LemonRhyme/xmicro-memory/README.md

# XMICRO-MEMORY

[XMICRO](https://github.com/x-microsystems/xmicro-bus) card providing 1MB of RAM and an optional relocatable 8KB EEPROM.

[Datasheet](Documentation/XMICRO-MEMORY.pdf)
