LemonRhyme/xmicro-memory/Documentation/Schematics/XMICRO-MEMORY V1.0 Black Large.pdf

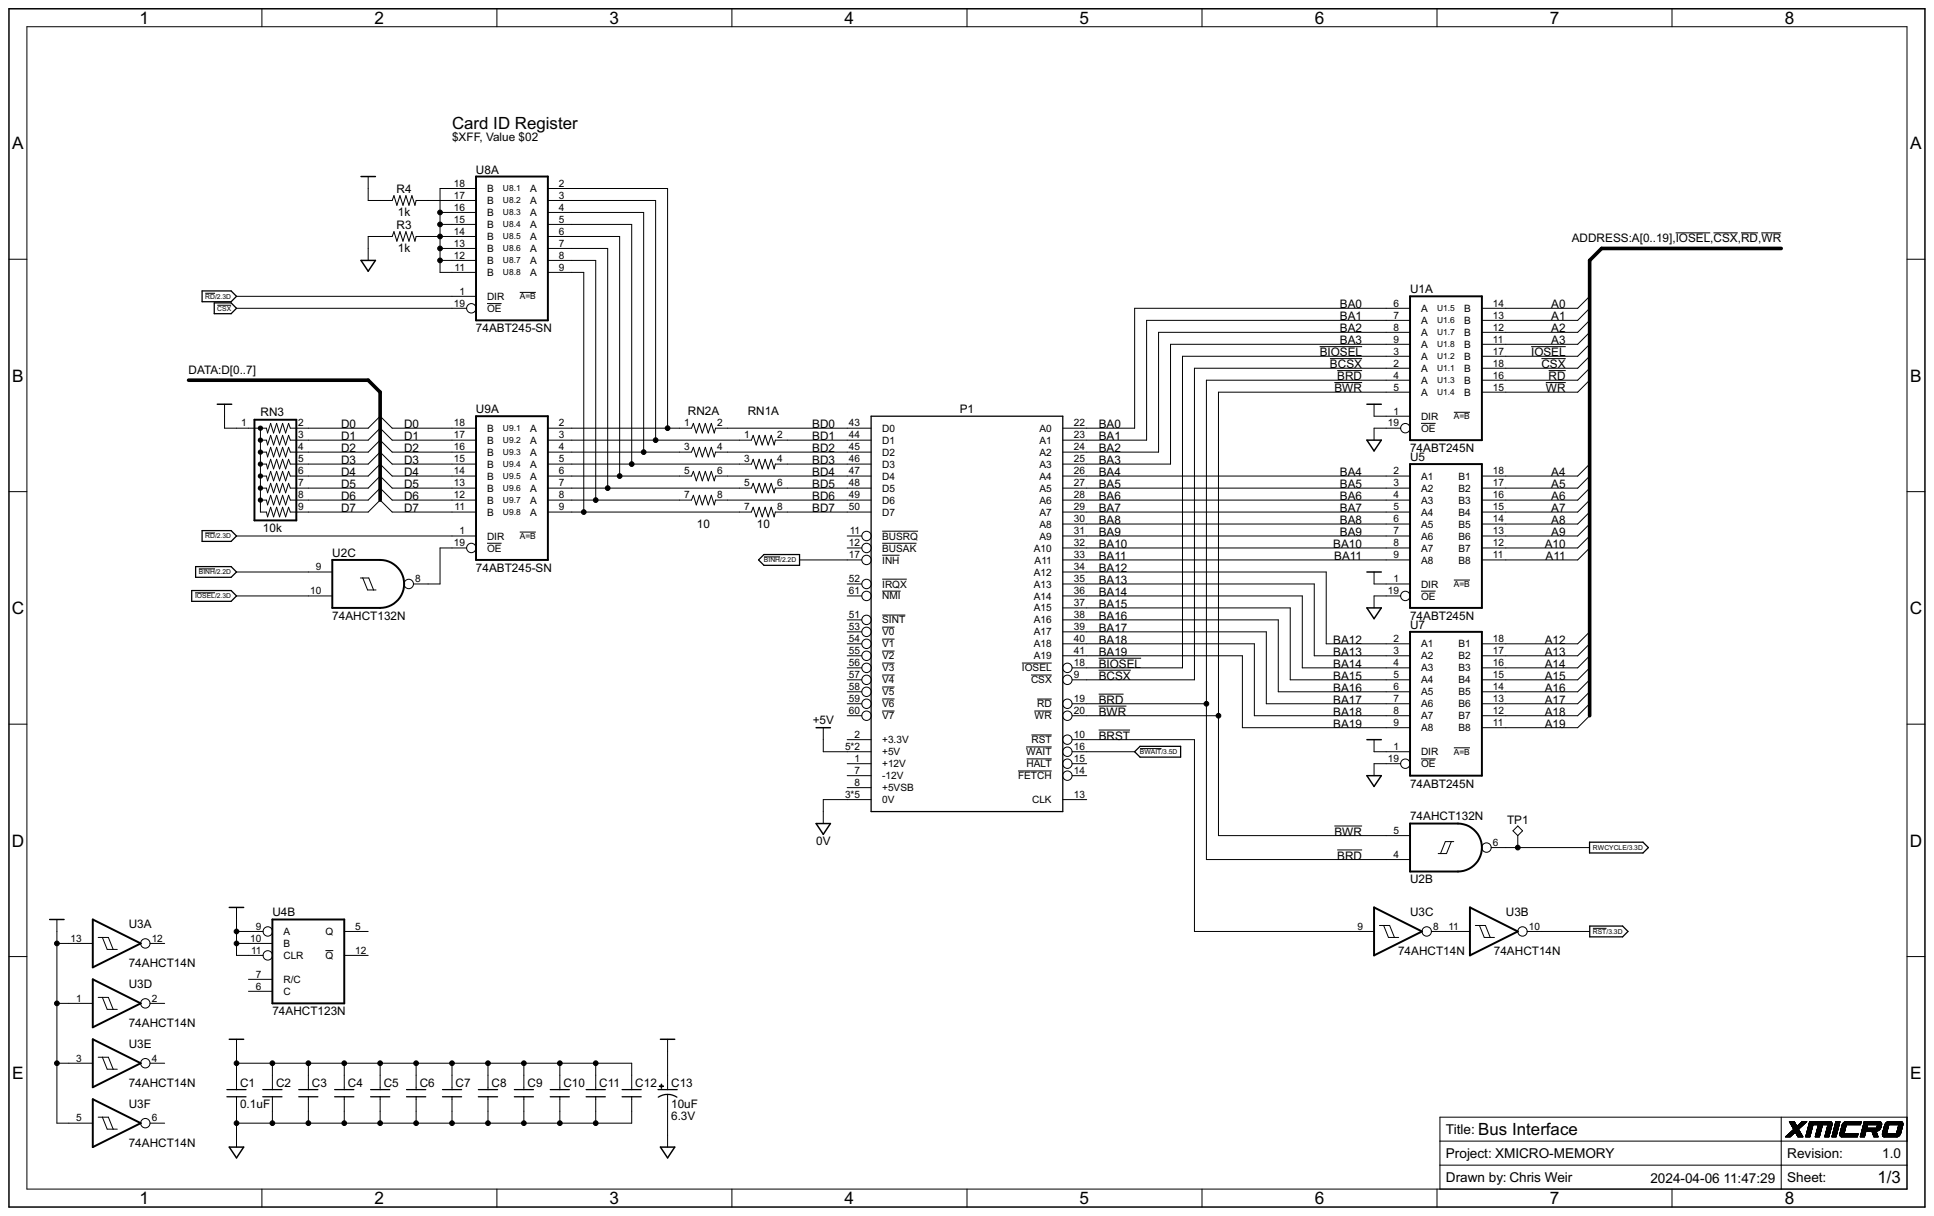
[picture p4: page 1]
