LemonRhyme/xmicro-memory/Documentation/Schematics/XMICRO-MEMORY V1.0 Color Large.pdf

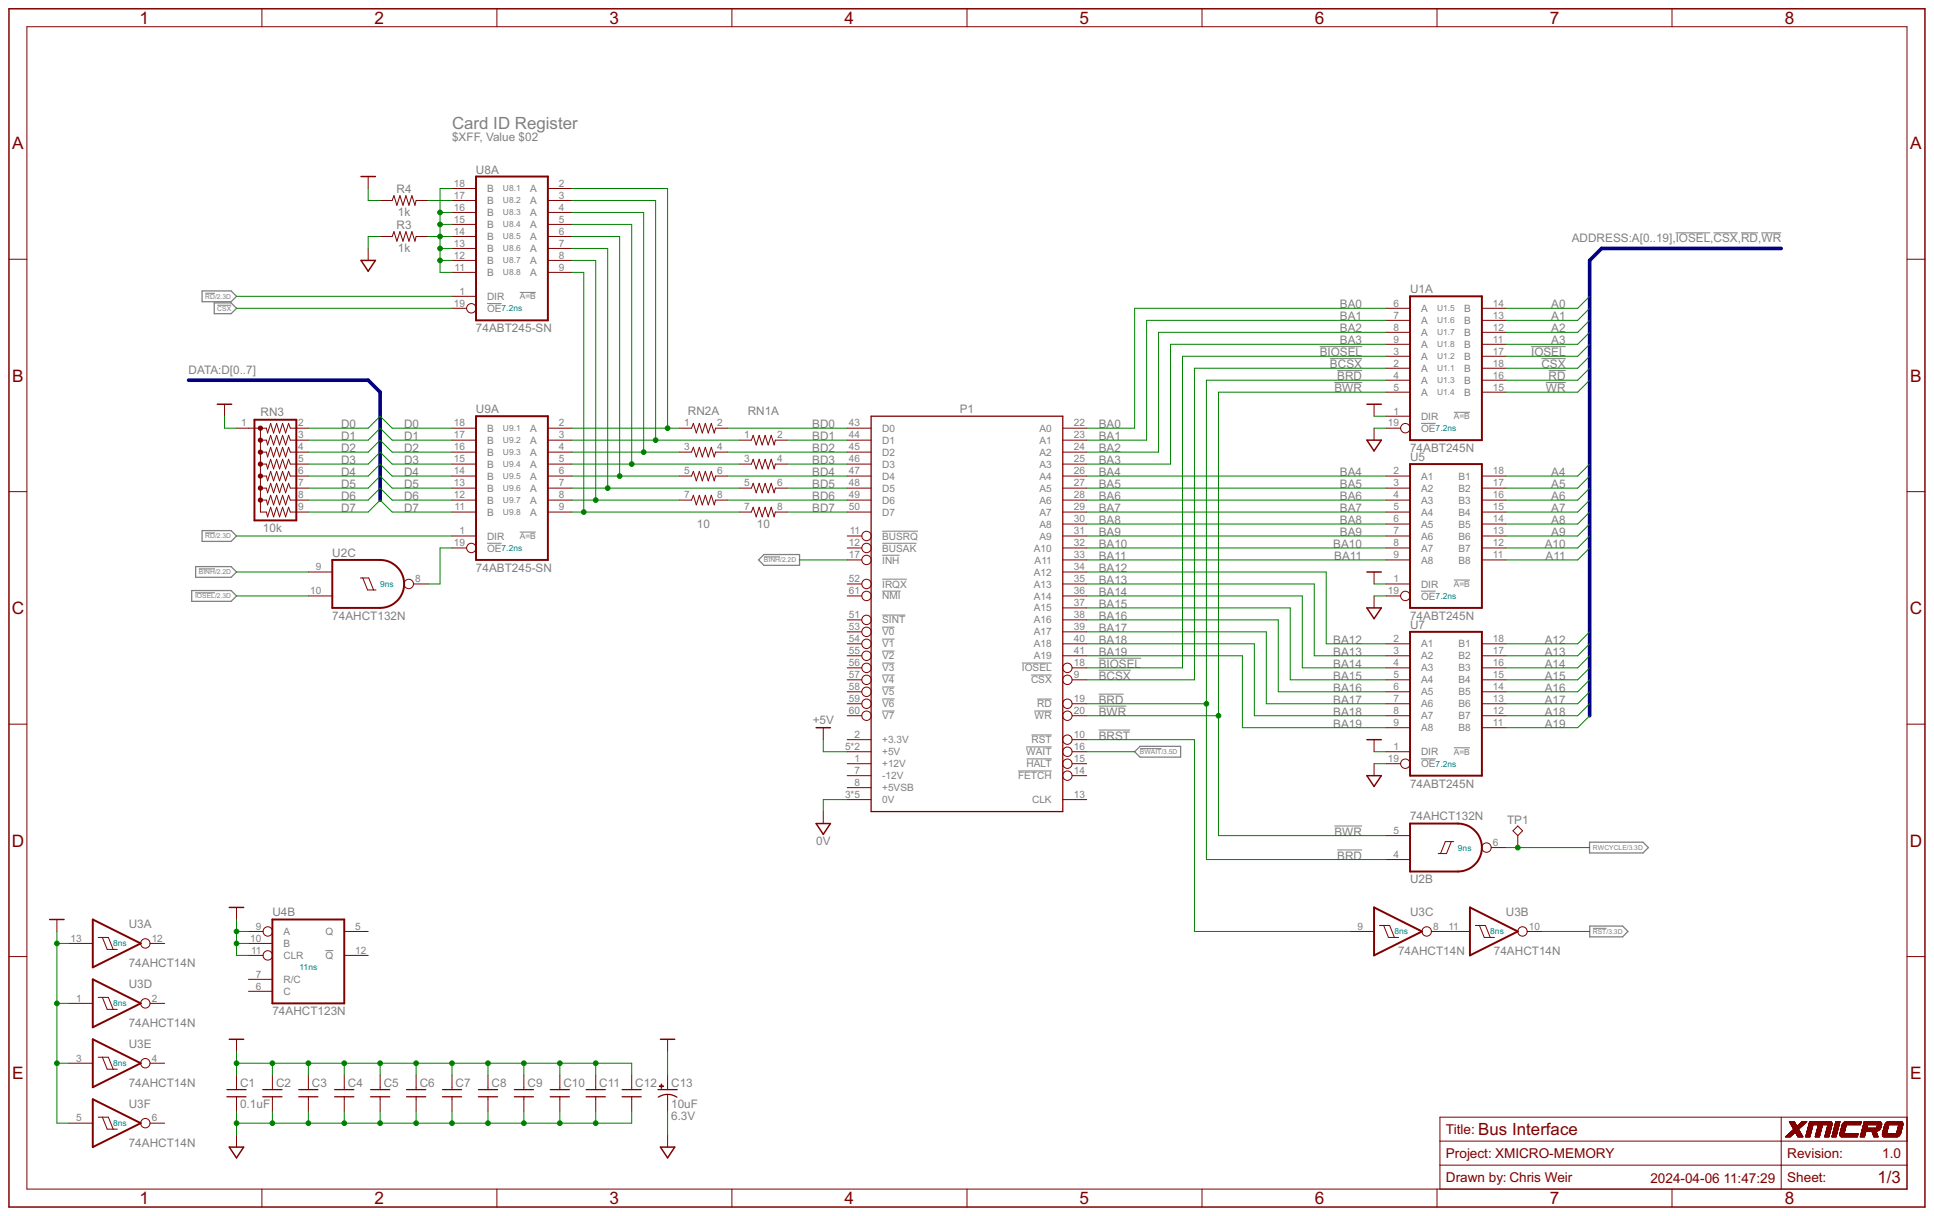
[picture p8: page 1]
