LemonRhyme/xmicro-memory/Documentation/Schematics/XMICRO-MEMORY V1.0 Color.pdf

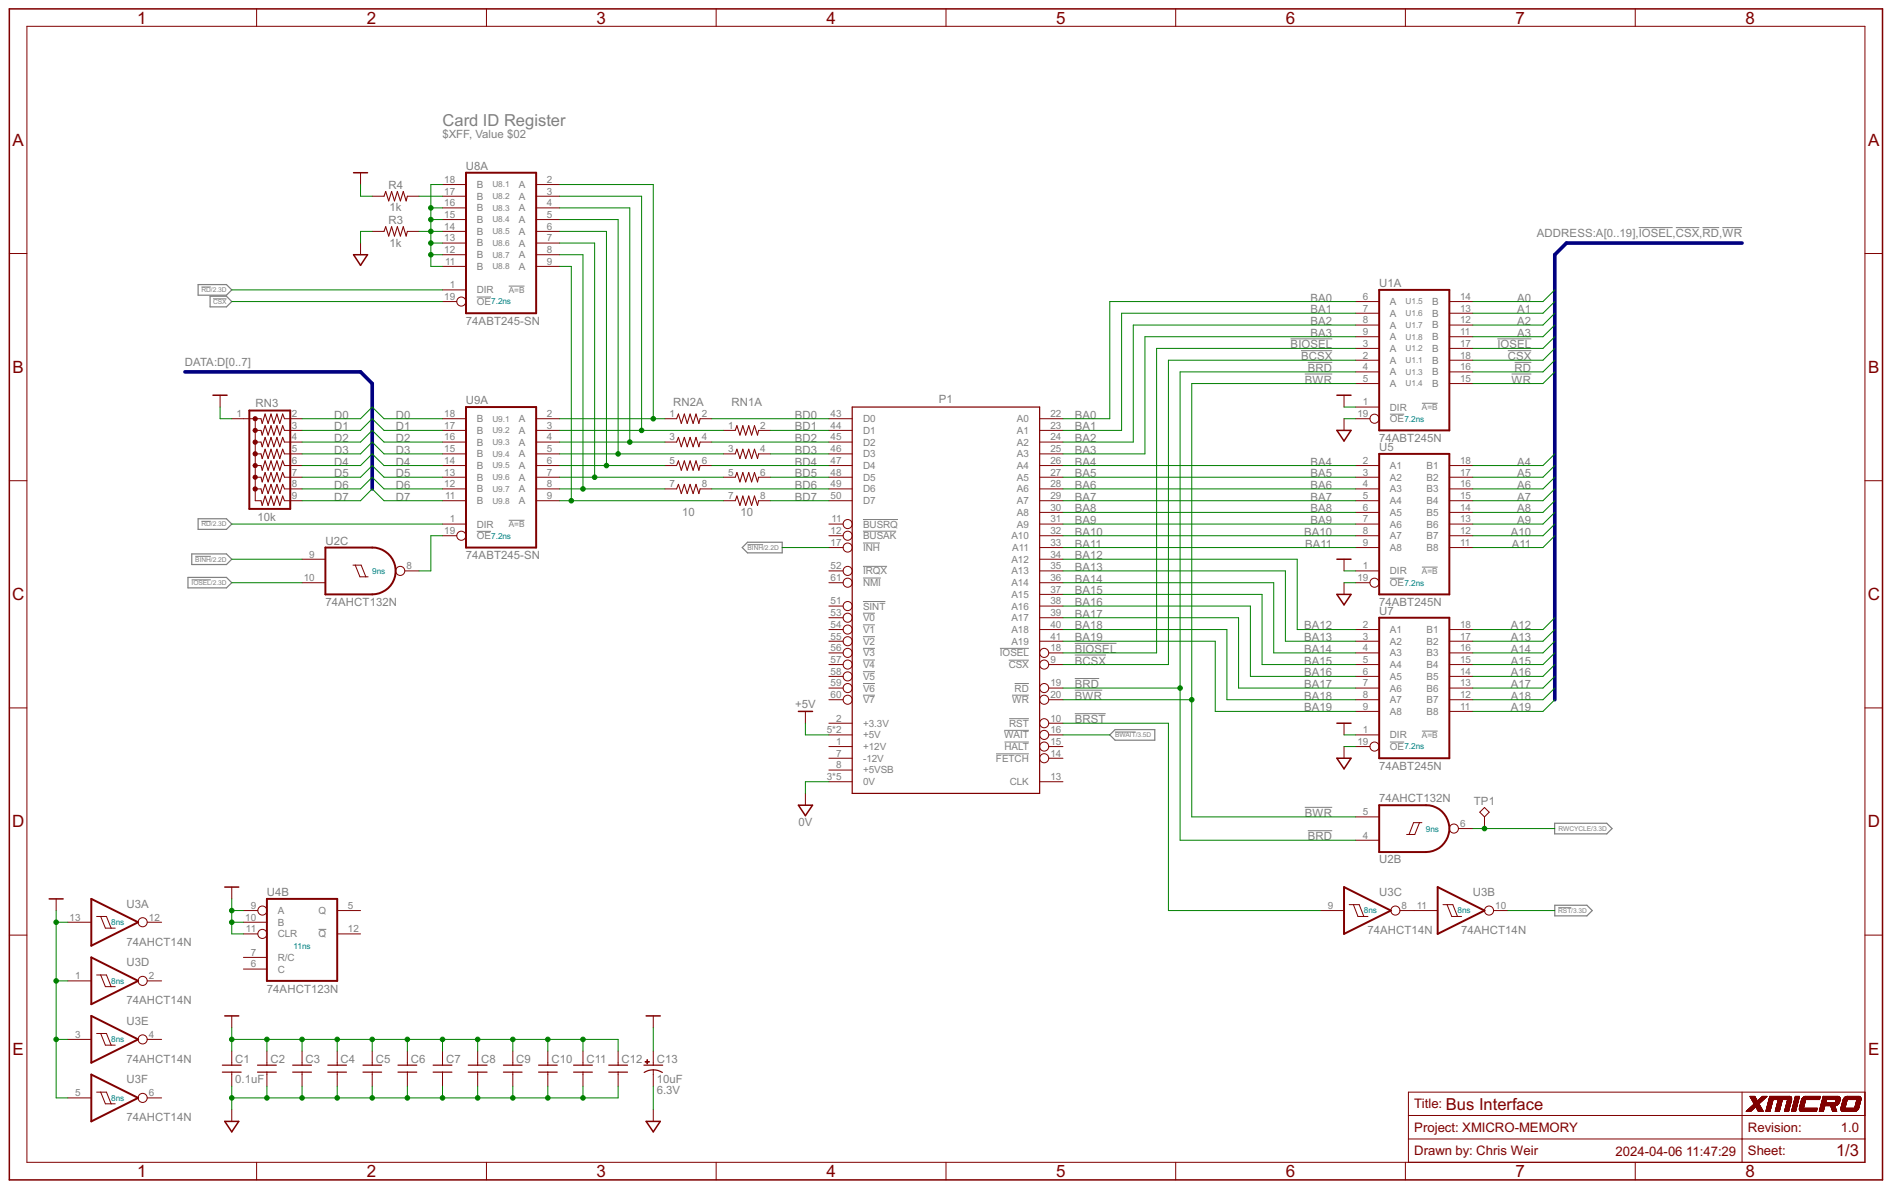
[picture p9: page 1]

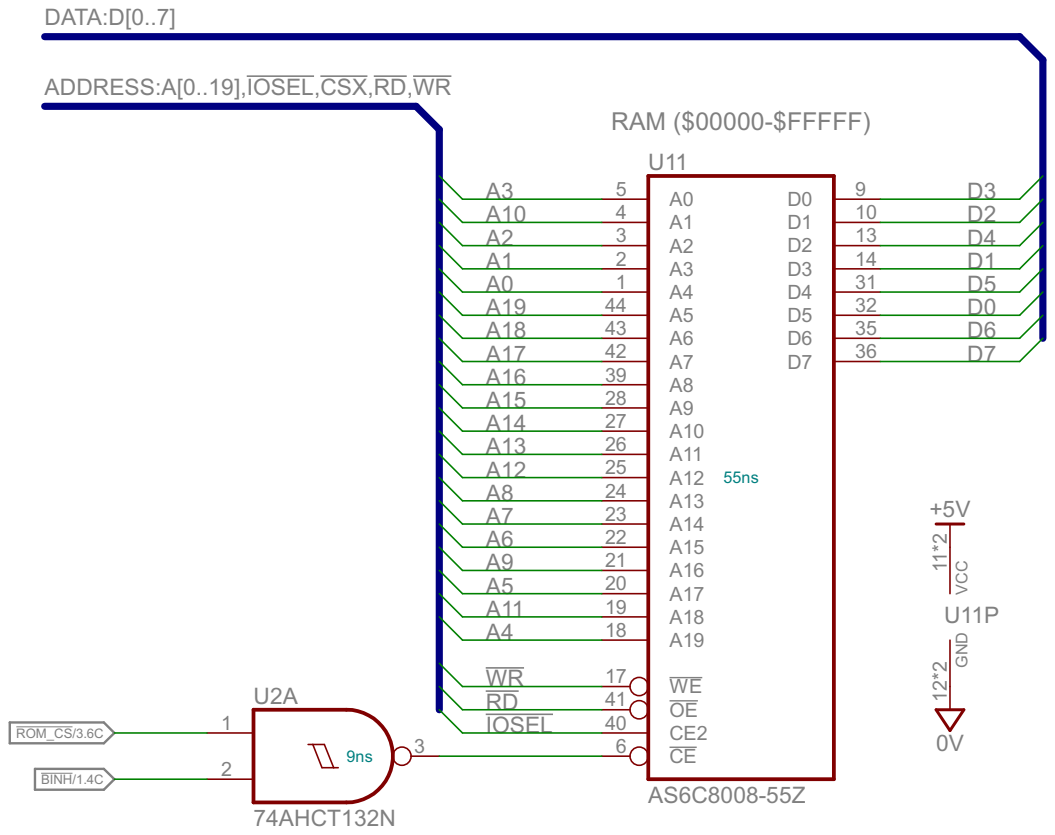
[picture p10: page 2]

ADDRESS:A[0..19],IOSEL,CSX,RD,WR

Title: Project: Drawn by: RAM XMICRO-MEMORY | Revision: Chris Weir Sheet: 2/3 1.0

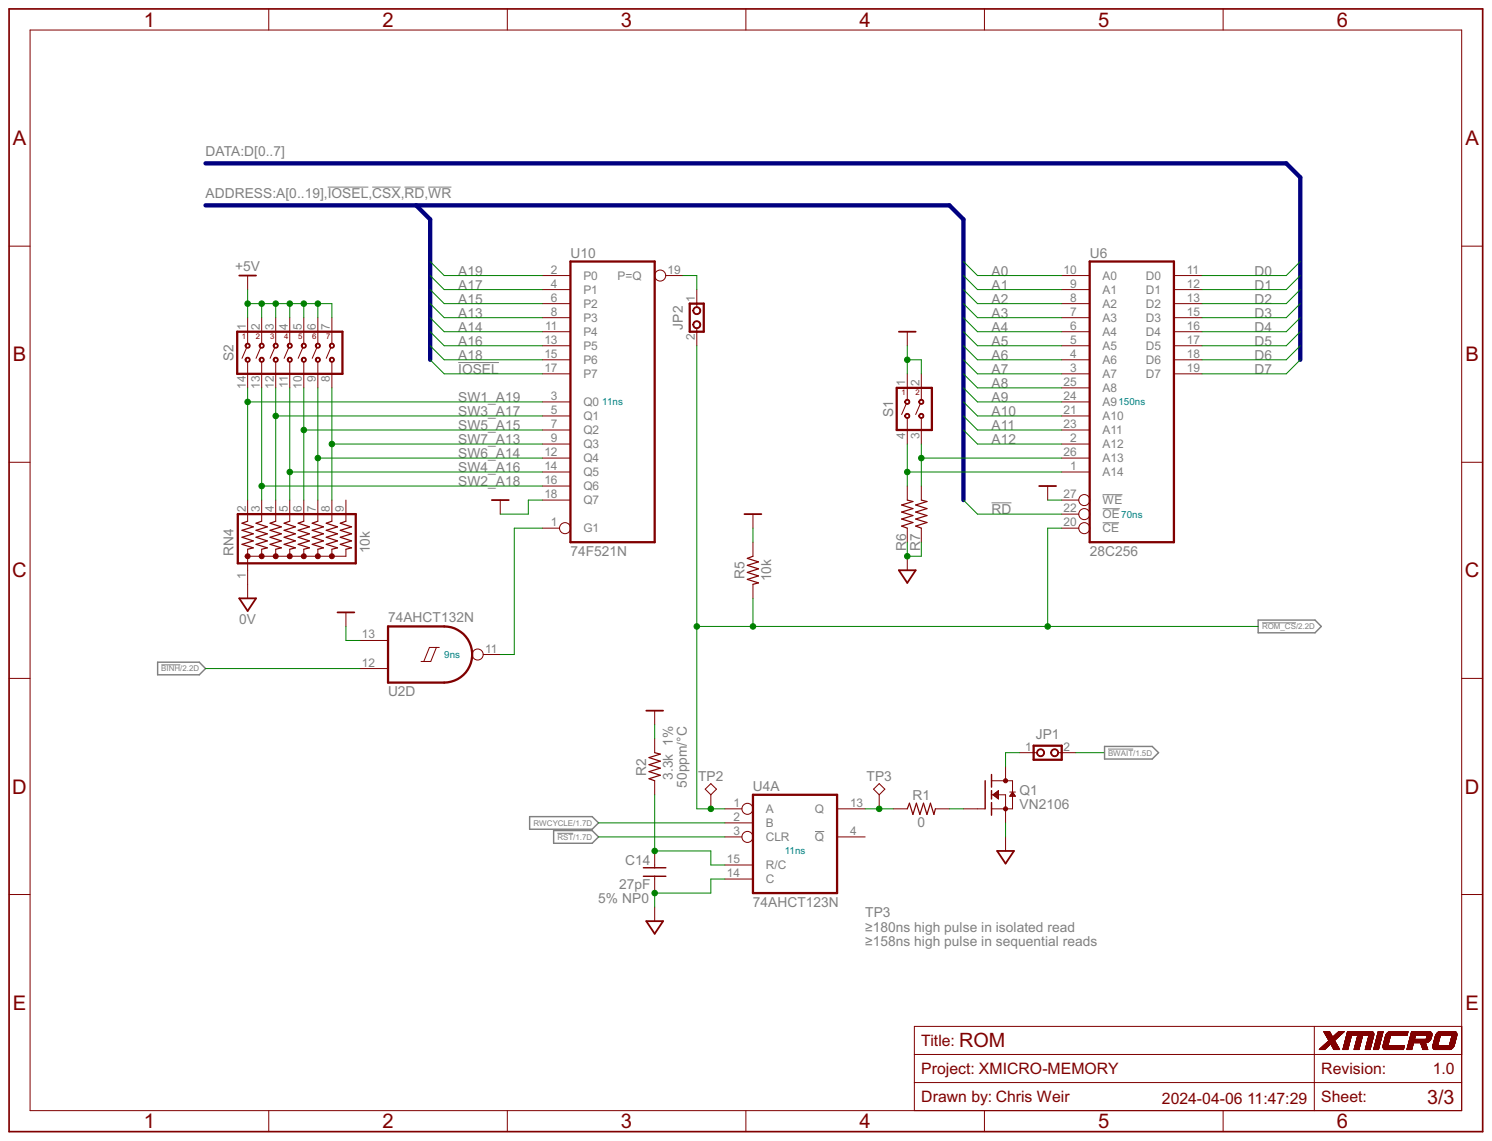
[picture p11: page 3]

ADDRESS:A[0..19],IOSEL,CSX,RD,WR

SW3_A17 5
SW5_A15 7
SW7_A13 9

≥180ns high pulse in isolated read
≥158ns high pulse in sequential reads

Title: Project: Drawn by: ROM XMICRO-MEMORY | Revision: Chris Weir Sheet: 3/3 1.0
