LemonRhyme/xmicro-memory/Hardware/CAD/XMICRO-MEMORY V1.0.brd

## EAGLE design Hardware/CAD/XMICRO-MEMORY V1.0.brd (2024-09-15)

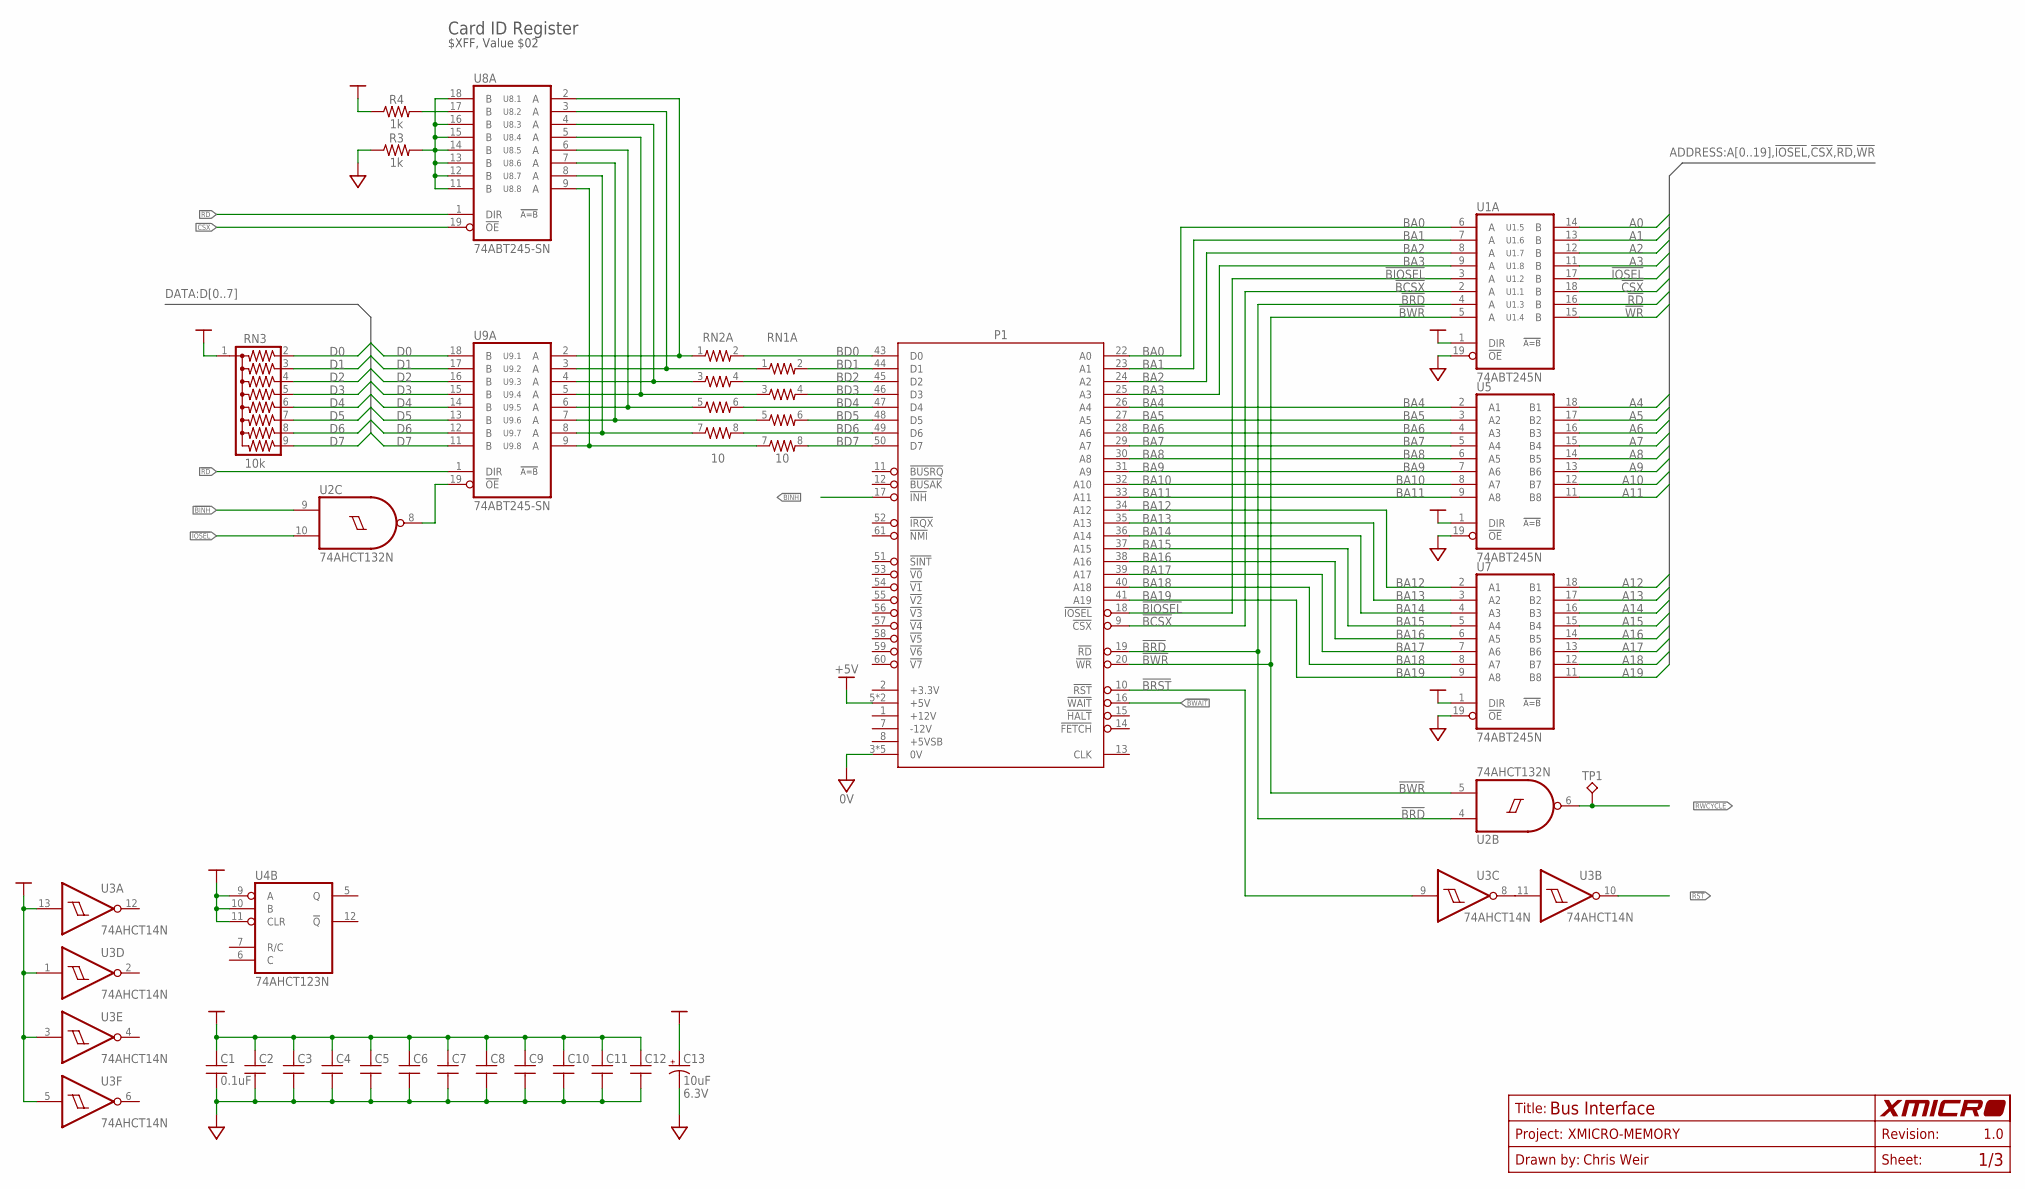
[picture p12: schematic XMICRO-MEMORY V1.0.sch, sheet 1, Bus Interface]

Parts:
C1, C2, C3, C4, C5, C6, C7, C8, C9, C10, C11, C12: 0.1uF; C025-024X044
C13: 10uF; E2,5-6; VOLTAGE 6.3V
P1: XMICRO-BUS-EDGE; EDGE62M
R3, R4: 1k; 0207/10
RN1, RN2: 10; SIL8
RN3: 10k; SIL9
TP1: TP-040
U1, U5, U7: 74ABT245N; DIL20
U2: 74AHCT132N; DIL14
U3: 74AHCT14N; DIL14
U4: 74AHCT123N; DIL16
U8, U9: 74ABT245-SN; DIL20

Connections:
0V: C1.2, C2.2, C3.2, C4.2, C5.2, C6.2, C7.2, C8.2, C9.2, C10.2, C11.2, C12.2, C13.-, P1.3 (0V), P1.4 (0V), P1.21 (0V), P1.42 (0V), P1.62 (0V), R3.1, U1.10 (0V), U1.19 (!OE), U2.7 (0V), U3.7 (0V), U4.8 (0V), U5.10 (0V), U5.19 (!OE), U7.10 (0V), U7.19 (!OE), U8.10 (0V), U9.10 (0V); also elsewhere on the board
!BCSX: P1.9 (!CSX), U1.2 (A)
!BINH: P1.17 (!INH), U2.9 (I0); also elsewhere on the board
!BIOSEL: P1.18 (!IOSEL), U1.3 (A)
!BRD: P1.19 (!RD), U1.4 (A), U2.4 (I0)
!BRST: P1.10 (!RST), U3.9 (I)
!BWAIT: P1.16 (!WAIT); also elsewhere on the board
!BWR: P1.20 (!WR), U1.5 (A), U2.5 (I1)
!CSX: U1.18 (B), U8.19 (!OE)
!IOSEL: U1.17 (B), U2.10 (I1); also elsewhere on the board
!RD: U1.16 (B), U8.1 (DIR), U9.1 (DIR); also elsewhere on the board
!RST: U3.10 (O); also elsewhere on the board
!WR: U1.15 (B); also elsewhere on the board
+5V: C1.1, C2.1, C3.1, C4.1, C5.1, C6.1, C7.1, C8.1, C9.1, C10.1, C11.1, C12.1, C13.+, P1.5 (+5V), P1.6 (+5V), R4.1, RN3.1, U1.1 (DIR), U1.20 (+5V), U2.14 (+5V), U3.1 (I), U3.3 (I), U3.5 (I), U3.13 (I), U3.14 (+5V), U4.9 (A), U4.10 (B), U4.11 (CLR), U4.16 (+5V), U5.1 (DIR), U5.20 (+5V), U7.1 (DIR), U7.20 (+5V), U8.20 (+5V), U9.20 (+5V); also elsewhere on the board
A0: U1.14 (B); also elsewhere on the board
A1: U1.13 (B); also elsewhere on the board
A2: U1.12 (B); also elsewhere on the board
A3: U1.11 (B); also elsewhere on the board
A4: U5.18 (B1); also elsewhere on the board
A5: U5.17 (B2); also elsewhere on the board
A6: U5.16 (B3); also elsewhere on the board
A7: U5.15 (B4); also elsewhere on the board
A8: U5.14 (B5); also elsewhere on the board
A9: U5.13 (B6); also elsewhere on the board
A10: U5.12 (B7); also elsewhere on the board
A11: U5.11 (B8); also elsewhere on the board
A12: U7.18 (B1); also elsewhere on the board
A13: U7.17 (B2); also elsewhere on the board
A14: U7.16 (B3); also elsewhere on the board
A15: U7.15 (B4); also elsewhere on the board
A16: U7.14 (B5); also elsewhere on the board
A17: U7.13 (B6); also elsewhere on the board
A18: U7.12 (B7); also elsewhere on the board
A19: U7.11 (B8); also elsewhere on the board
BA0: P1.22 (A0), U1.6 (A)
BA1: P1.23 (A1), U1.7 (A)
BA2: P1.24 (A2), U1.8 (A)
BA3: P1.25 (A3), U1.9 (A)
BA4: P1.26 (A4), U5.2 (A1)
BA5: P1.27 (A5), U5.3 (A2)
BA6: P1.28 (A6), U5.4 (A3)
BA7: P1.29 (A7), U5.5 (A4)
BA8: P1.30 (A8), U5.6 (A5)
BA9: P1.31 (A9), U5.7 (A6)
BA10: P1.32 (A10), U5.8 (A7)
BA11: P1.33 (A11), U5.9 (A8)
BA12: P1.34 (A12), U7.2 (A1)
BA13: P1.35 (A13), U7.3 (A2)
BA14: P1.36 (A14), U7.4 (A3)
BA15: P1.37 (A15), U7.5 (A4)
BA16: P1.38 (A16), U7.6 (A5)
BA17: P1.39 (A17), U7.7 (A6)
BA18: P1.40 (A18), U7.8 (A7)
BA19: P1.41 (A19), U7.9 (A8)
BD0: P1.43 (D0), RN2.2
BD1: P1.44 (D1), RN1.2
BD2: P1.45 (D2), RN2.4 (2)
BD3: P1.46 (D3), RN1.4 (2)
BD4: P1.47 (D4), RN2.6 (2)
BD5: P1.48 (D5), RN1.6 (2)
BD6: P1.49 (D6), RN2.8 (2)
BD7: P1.50 (D7), RN1.8 (2)
D0: RN3.2, U9.18 (B); also elsewhere on the board
D1: RN3.3, U9.17 (B); also elsewhere on the board
D2: RN3.4, U9.16 (B); also elsewhere on the board
D3: RN3.5, U9.15 (B); also elsewhere on the board
D4: RN3.6, U9.14 (B); also elsewhere on the board
D5: RN3.7, U9.13 (B); also elsewhere on the board
D6: RN3.8, U9.12 (B); also elsewhere on the board
D7: RN3.9, U9.11 (B); also elsewhere on the board
unnamed: R3.2, U8.11 (B), U8.12 (B), U8.13 (B), U8.14 (B), U8.15 (B), U8.16 (B), U8.18 (B)
unnamed: R4.2, U8.17 (B)
unnamed: U3.8 (O), U3.11 (I)
unnamed: U2.8 (O), U9.19 (!OE)
unnamed: RN2.1, U8.2 (A), U9.2 (A)
unnamed: RN1.1, U8.3 (A), U9.3 (A)
unnamed: RN2.3 (1), U8.4 (A), U9.4 (A)
unnamed: RN1.3 (1), U8.5 (A), U9.5 (A)
unnamed: RN2.5 (1), U8.6 (A), U9.6 (A)
unnamed: RN1.5 (1), U8.7 (A), U9.7 (A)
unnamed: RN2.7 (1), U8.8 (A), U9.8 (A)
unnamed: RN1.7 (1), U8.9 (A), U9.9 (A)
RWCYCLE: TP1.1, U2.6 (O); also elsewhere on the board

Notes on the sheet:
Card ID Register
$XFF, Value $02

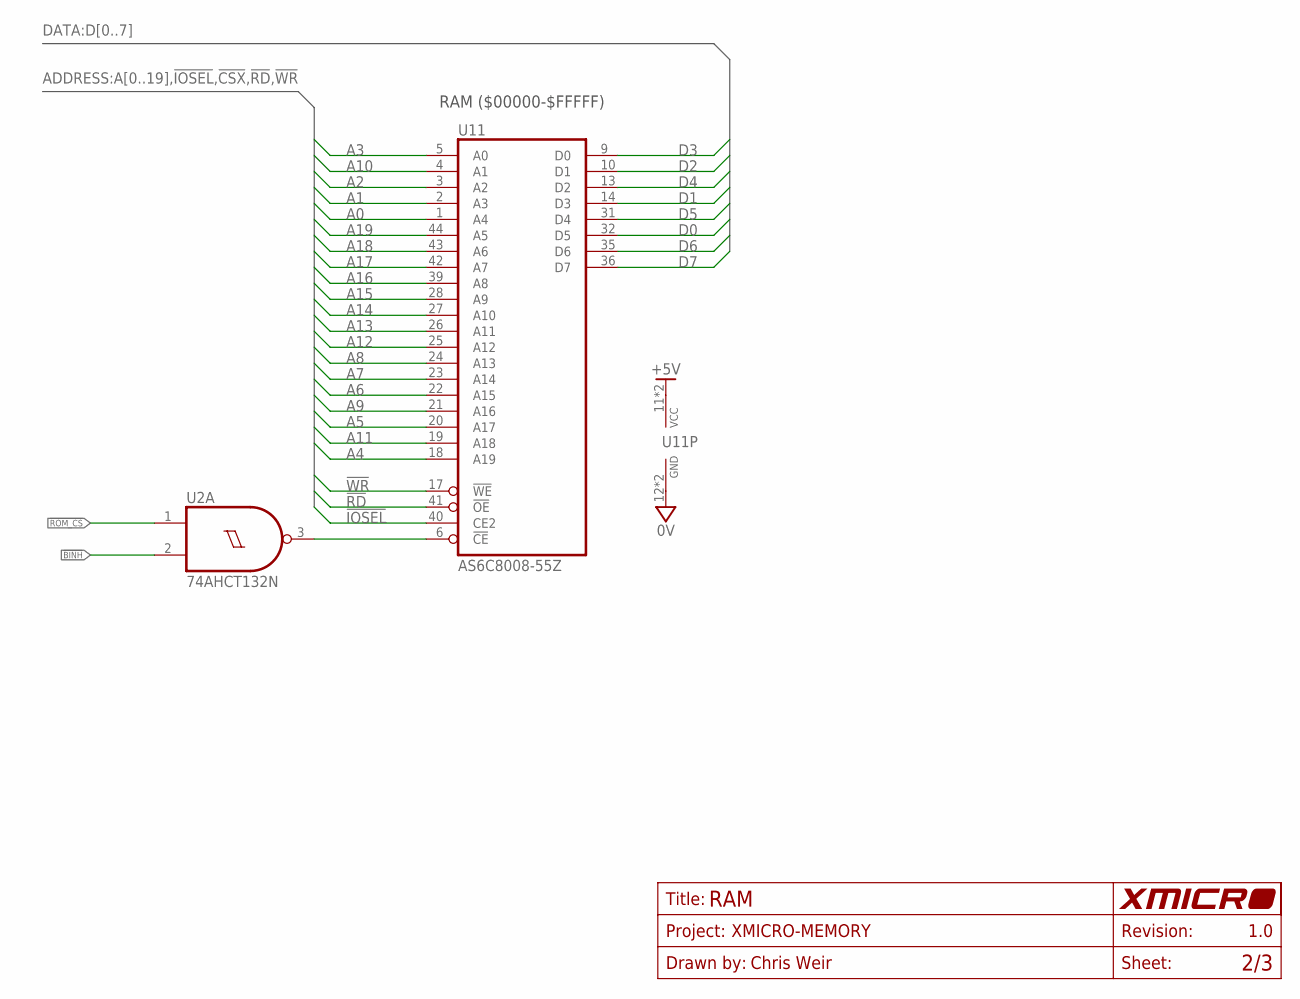
[picture p13: schematic XMICRO-MEMORY V1.0.sch, sheet 2, RAM]

Parts:
U2: 74AHCT132N; DIL14
U11: AS6C8008-55Z; TSOP44-II

Connections:
0V: U2.7 (0V), U11.12 (0V), U11.34 (0V); also elsewhere on the board
!BINH: U2.2 (I1); also elsewhere on the board
!IOSEL: U11.40 (CE2); also elsewhere on the board
!RD: U11.41 (!OE); also elsewhere on the board
!ROM_CS: U2.1 (I0); also elsewhere on the board
!WR: U11.17 (!WE); also elsewhere on the board
+5V: U2.14 (+5V), U11.11 (+5V), U11.33 (+5V); also elsewhere on the board
A0: U11.1 (A4); also elsewhere on the board
A1: U11.2 (A3); also elsewhere on the board
A2: U11.3 (A2); also elsewhere on the board
A3: U11.5 (A0); also elsewhere on the board
A4: U11.18 (A19); also elsewhere on the board
A5: U11.20 (A17); also elsewhere on the board
A6: U11.22 (A15); also elsewhere on the board
A7: U11.23 (A14); also elsewhere on the board
A8: U11.24 (A13); also elsewhere on the board
A9: U11.21 (A16); also elsewhere on the board
A10: U11.4 (A1); also elsewhere on the board
A11: U11.19 (A18); also elsewhere on the board
A12: U11.25 (A12); also elsewhere on the board
A13: U11.26 (A11); also elsewhere on the board
A14: U11.27 (A10); also elsewhere on the board
A15: U11.28 (A9); also elsewhere on the board
A16: U11.39 (A8); also elsewhere on the board
A17: U11.42 (A7); also elsewhere on the board
A18: U11.43 (A6); also elsewhere on the board
A19: U11.44 (A5); also elsewhere on the board
D0: U11.32 (D5); also elsewhere on the board
D1: U11.14 (D3); also elsewhere on the board
D2: U11.10 (D1); also elsewhere on the board
D3: U11.9 (D0); also elsewhere on the board
D4: U11.13 (D2); also elsewhere on the board
D5: U11.31 (D4); also elsewhere on the board
D6: U11.35 (D6); also elsewhere on the board
D7: U11.36 (D7); also elsewhere on the board
unnamed: U2.3 (O), U11.6 (!CE)

Notes on the sheet:
RAM ($00000-$FFFFF)

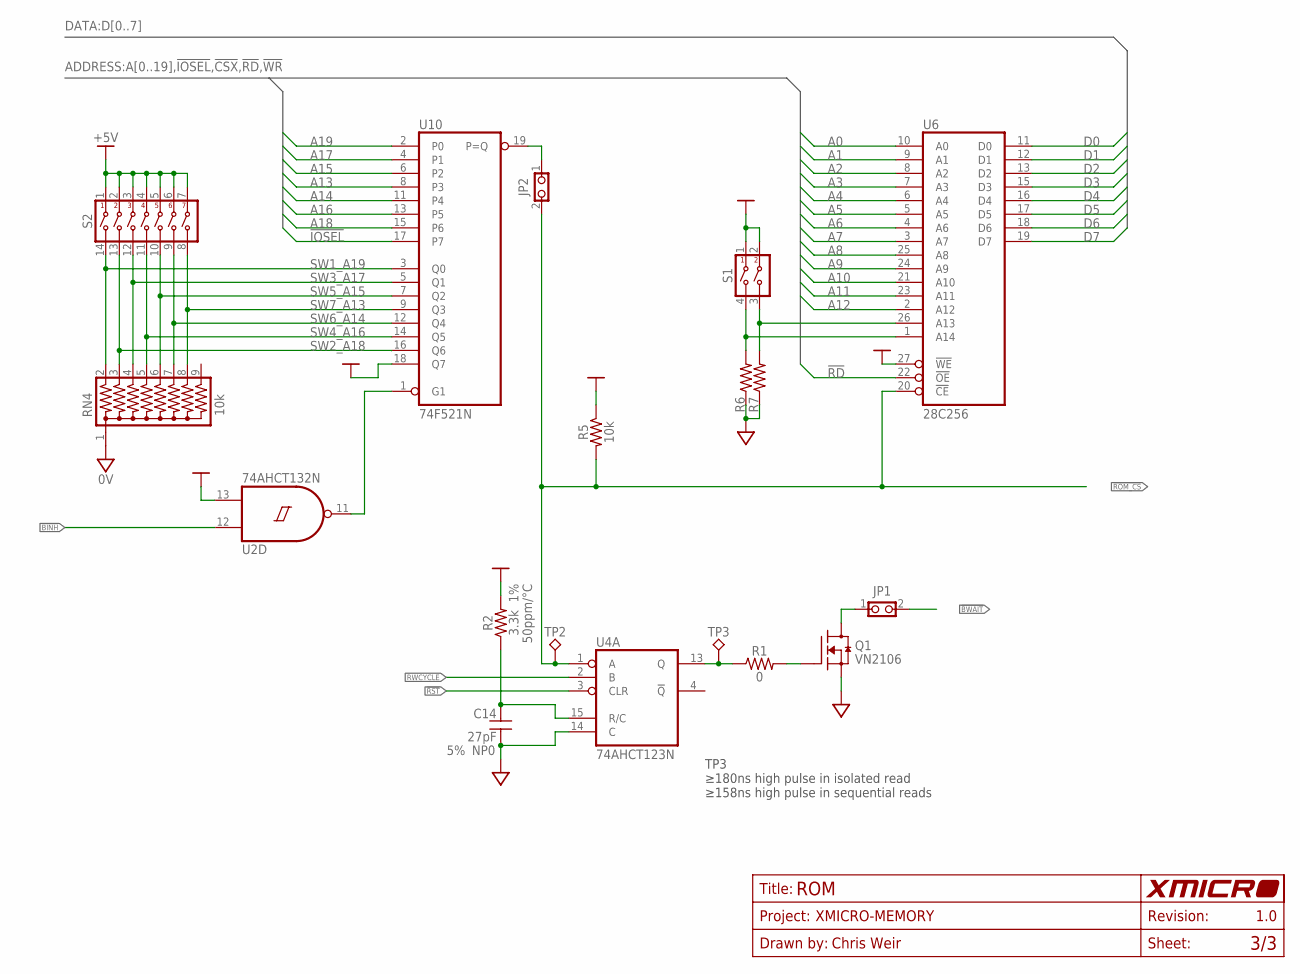
[picture p14: schematic XMICRO-MEMORY V1.0.sch, sheet 3, ROM]

Parts:
C14: 27pF; C025-024X044; TOLERANCE 5%
JP1, JP2: 1X2-THRU; 1X2
Q1: VN2106; TO92
R1: 0; 0207/10
R2: 3.3k; 0207/10; TOLERANCE 1%
R5, R6, R7: 10k; 0207/10
RN4: 10k; SIL9
S1: SW-DIP02; SW-DIP2
S2: SW-DIP07; SW-DIP7
TP2, TP3: TP-040
U2: 74AHCT132N; DIL14
U4: 74AHCT123N; DIL16
U6: 28C256; 228-1277-00
U10: 74F521N; DIL20

Connections:
0V: C14.2, Q1.1 (S), R6.1, R7.1, RN4.1, U2.7 (0V), U4.8 (0V), U4.14 (C), U6.14 (0V), U10.10 (0V); also elsewhere on the board
!BINH: U2.12 (I0); also elsewhere on the board
!BWAIT: JP1.2; also elsewhere on the board
!IOSEL: U10.17 (P7); also elsewhere on the board
!RD: U6.22 (!OE); also elsewhere on the board
!ROM_CS: JP2.2, R5.2, TP2.1, U4.1 (A), U6.20 (!CE); also elsewhere on the board
!RST: U4.3 (CLR); also elsewhere on the board
+5V: R2.2, R5.1, S1.1, S1.2, S2.1, S2.2, S2.3, S2.4, S2.5, S2.6, S2.7, U2.13 (I1), U2.14 (+5V), U4.16 (+5V), U6.27 (!WE), U6.28 (+5V), U10.18 (Q7), U10.20 (+5V); also elsewhere on the board
A0: U6.10 (A0); also elsewhere on the board
A1: U6.9 (A1); also elsewhere on the board
A2: U6.8 (A2); also elsewhere on the board
A3: U6.7 (A3); also elsewhere on the board
A4: U6.6 (A4); also elsewhere on the board
A5: U6.5 (A5); also elsewhere on the board
A6: U6.4 (A6); also elsewhere on the board
A7: U6.3 (A7); also elsewhere on the board
A8: U6.25 (A8); also elsewhere on the board
A9: U6.24 (A9); also elsewhere on the board
A10: U6.21 (A10); also elsewhere on the board
A11: U6.23 (A11); also elsewhere on the board
A12: U6.2 (A12); also elsewhere on the board
A13: U10.8 (P3); also elsewhere on the board
A14: U10.11 (P4); also elsewhere on the board
A15: U10.6 (P2); also elsewhere on the board
A16: U10.13 (P5); also elsewhere on the board
A17: U10.4 (P1); also elsewhere on the board
A18: U10.15 (P6); also elsewhere on the board
A19: U10.2 (P0); also elsewhere on the board
D0: U6.11 (D0); also elsewhere on the board
D1: U6.12 (D1); also elsewhere on the board
D2: U6.13 (D2); also elsewhere on the board
D3: U6.15 (D3); also elsewhere on the board
D4: U6.16 (D4); also elsewhere on the board
D5: U6.17 (D5); also elsewhere on the board
D6: U6.18 (D6); also elsewhere on the board
D7: U6.19 (D7); also elsewhere on the board
unnamed: JP2.1, U10.19 (P=Q)
unnamed: Q1.2 (G), R1.2
unnamed: JP1.1, Q1.3 (D)
unnamed: R7.2, S1.3, U6.26 (A13)
unnamed: R6.2, S1.4, U6.1 (A14)
unnamed: U2.11 (O), U10.1 (G1)
unnamed: C14.1, R2.1, U4.15 (R/C)
RWCYCLE: U4.2 (B); also elsewhere on the board
SW1_A19: RN4.2, S2.14, U10.3 (Q0)
SW2_A18: RN4.3, S2.13, U10.16 (Q6)
SW3_A17: RN4.4, S2.12, U10.5 (Q1)
SW4_A16: RN4.5, S2.11, U10.14 (Q5)
SW5_A15: RN4.6, S2.10, U10.7 (Q2)
SW6_A14: RN4.7, S2.9, U10.12 (Q4)
SW7_A13: RN4.8, S2.8, U10.9 (Q3)
WAIT_ROM: R1.1, TP3.1, U4.13 (Q)

Notes on the sheet:
TP3 ≥180ns high pulse in isolated read ≥158ns high pulse in sequential reads

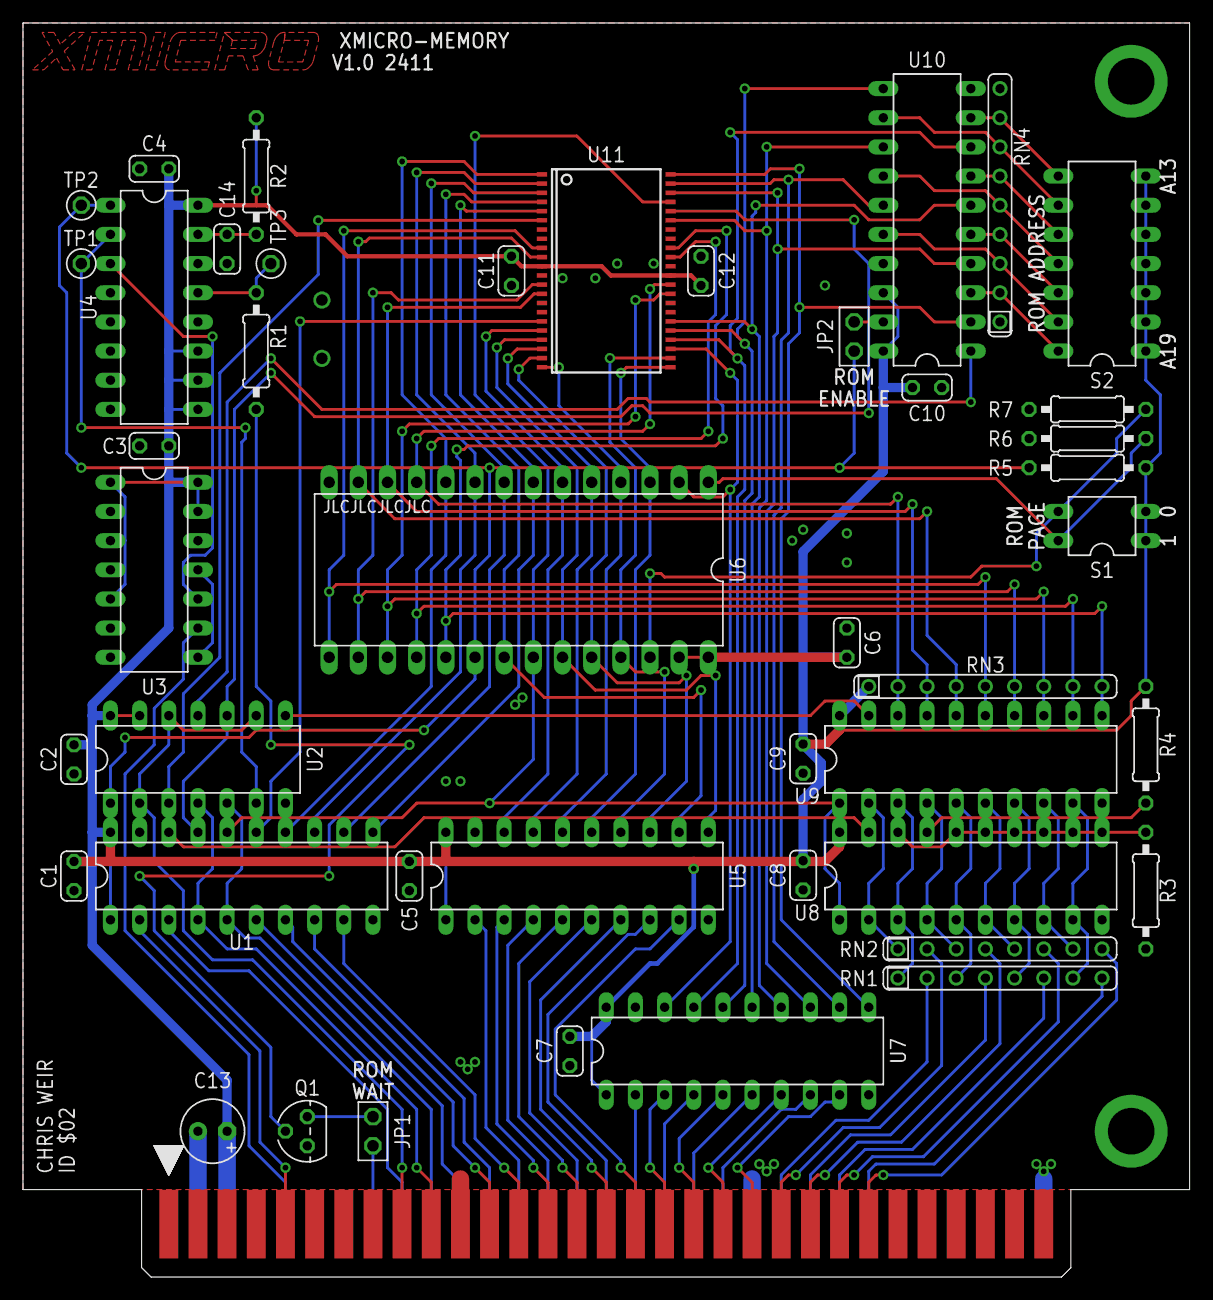
[picture p15: board XMICRO-MEMORY V1.0.brd from above]

Board: 2 copper layers, 101.6 x 109.2 mm, 45 parts (0 on the bottom side), 100 nets.
