LemonRhyme/xmicro-memory/(commit log)

2019-05-28 Updated schematic xrefs to indicate signal direction.
    [XMICRO-MEMORY.sch]
2019-05-28 Updated directory structure
    [XMICRO-MEMORY BOM.csv, XMICRO-MEMORY.brd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]
2024-09-15 Updated to Gen 2 V1.0
    [XMICRO-MEMORY BOM.csv, XMICRO-MEMORY V1.0.brd, XMICRO-MEMORY V1.0.sch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]
